halherta/16ChannelServoControllerDaughterboardDesign/README.md

# 16ChannelServoControllerDaughterboardDesign
16 Channel Servo (&amp; PWM) Controller Daughterboard Design using a PCA9685. Part of the IOT innovation station project
