halherta/16ChannelServoControllerDaughterboardDesign/16ChannelServoControllerDaughterboardDesign.kicad_pcb

## KiCad design 16ChannelServoControllerDaughterboardDesign.kicad_pcb (2025-09-30)

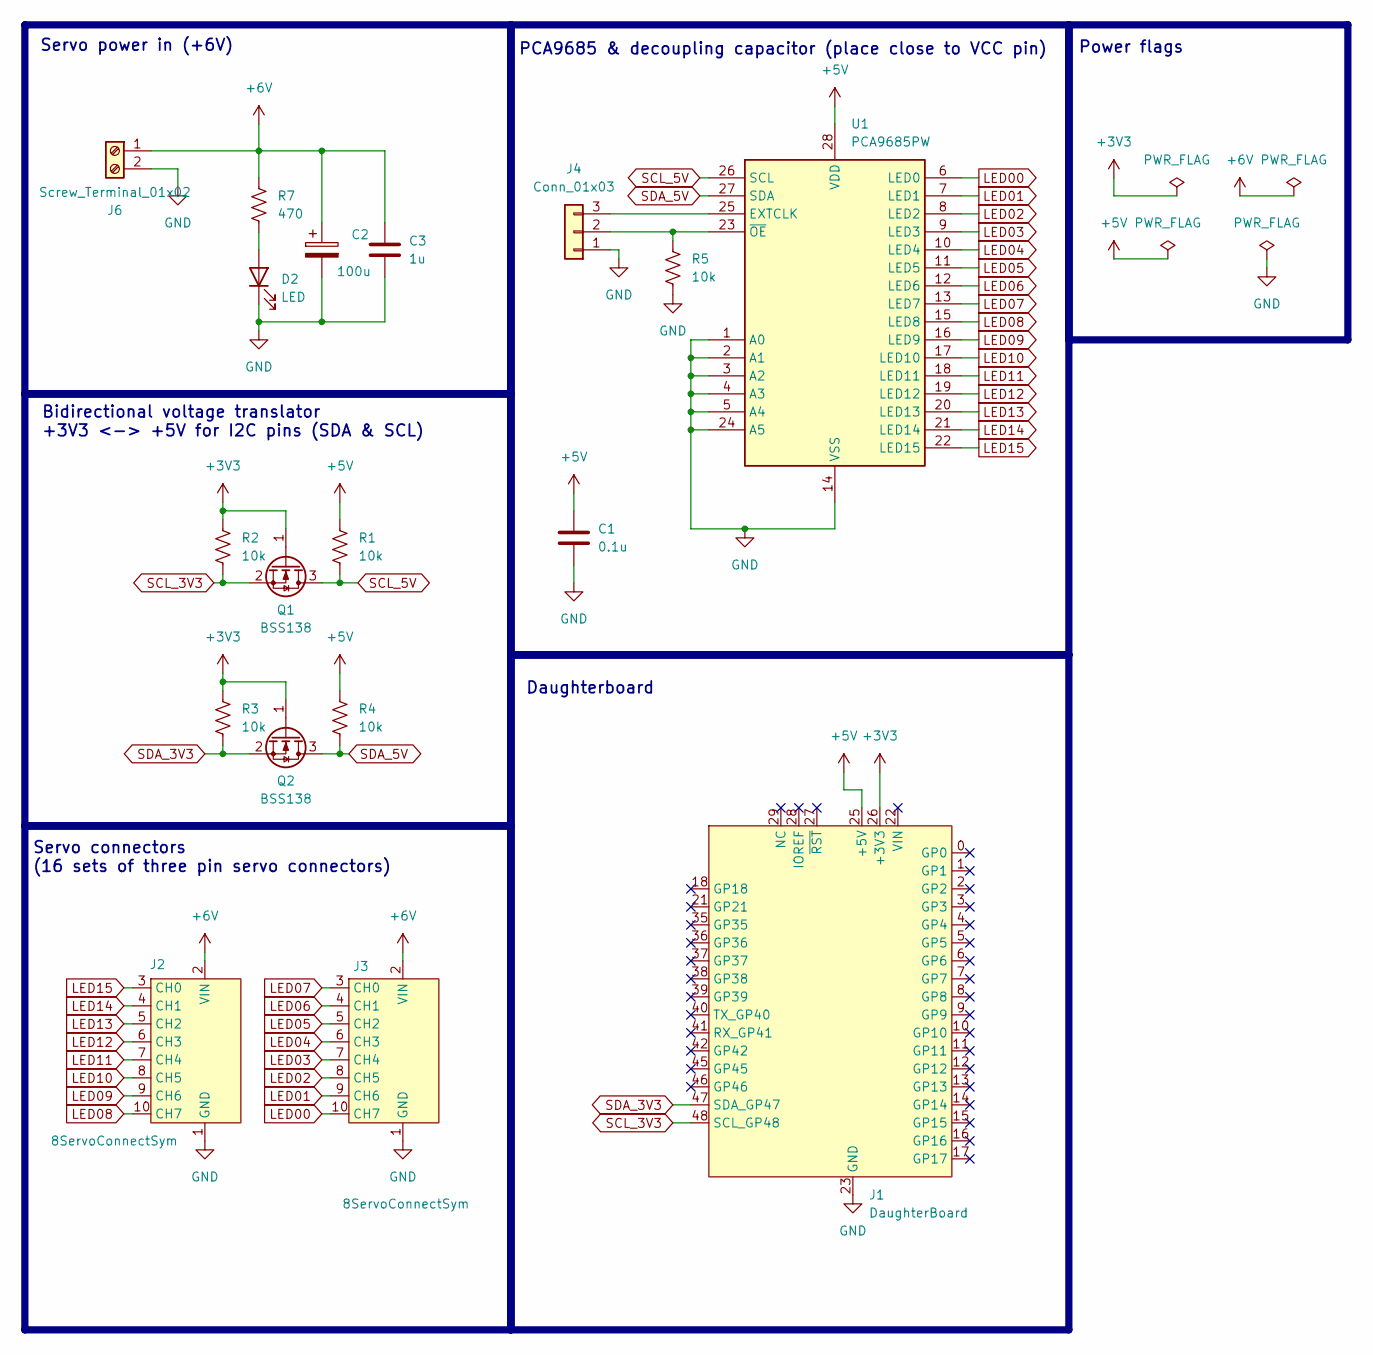
[picture p1: schematic 16ChannelServoControllerDaughterboardDesign.kicad_sch]

Parts:
C1: 0.1u; C_1206_3216Metric_Pad1.33x1.80mm_HandSolder
C2: 100u; CP_Elec_6.3x7.7
C3: 1u; C_1206_3216Metric_Pad1.33x1.80mm_HandSolder
D2: LED; LED_1206_3216Metric_Pad1.42x1.75mm_HandSolder
J1: DaughterBoard; DaughterBoardTemplate
J2, J3: 8ServoConnectSym; 8ServoConnect
J4: Conn_01x03; PinHeader_1x03_P2.54mm_Vertical
J6: Screw_Terminal_01x02; TerminalBlock_Phoenix_MKDS-1,5-2_1x02_P5.00mm_Horizontal
Q1, Q2: BSS138; SOT-23
R1, R2, R3, R4, R5: 10k; R_1206_3216Metric_Pad1.30x1.75mm_HandSolder
R7: 470; R_1206_3216Metric_Pad1.30x1.75mm_HandSolder
U1: PCA9685PW; TSSOP-28_4.4x9.7mm_P0.65mm

Connections:
+3V3: J1.26 (+3V3), J1.32 (+3V3), Q1.1 (G), Q2.1 (G), R2.1, R3.1
+5V: C1.1, J1.25 (+5V), R1.1, R4.1, U1.28 (VDD)
+6V: C2.1, C3.1, J2.2 (VIN), J3.2 (VIN), J6.1, R7.1
GND: C1.2, C2.2, C3.2, D2.1 (K), J1.23 (GND), J1.24 (GND), J1.30 (GND), J2.1 (GND), J3.1 (GND), J4.1, J6.2, R5.2, U1.1 (A0), U1.2 (A1), U1.3 (A2), U1.4 (A3), U1.5 (A4), U1.14 (VSS), U1.24 (A5)
LED00: J3.10 (CH7), U1.6 (LED0)
LED01: J3.9 (CH6), U1.7 (LED1)
LED02: J3.8 (CH5), U1.8 (LED2)
LED03: J3.7 (CH4), U1.9 (LED3)
LED04: J3.6 (CH3), U1.10 (LED4)
LED05: J3.5 (CH2), U1.11 (LED5)
LED06: J3.4 (CH1), U1.12 (LED6)
LED07: J3.3 (CH0), U1.13 (LED7)
LED08: J2.10 (CH7), U1.15 (LED8)
LED09: J2.9 (CH6), U1.16 (LED9)
LED10: J2.8 (CH5), U1.17 (LED10)
LED11: J2.7 (CH4), U1.18 (LED11)
LED12: J2.6 (CH3), U1.19 (LED12)
LED13: J2.5 (CH2), U1.20 (LED13)
LED14: J2.4 (CH1), U1.21 (LED14)
LED15: J2.3 (CH0), U1.22 (LED15)
unnamed: D2.2 (A), R7.2
unnamed: J4.2, R5.1, U1.23 (~OE)
unnamed: J4.3, U1.25 (EXTCLK)
SCL_3V3: J1.48 (SCL_GP48), Q1.2 (S), R2.2
SCL_5V: Q1.3 (D), R1.2, U1.26 (SCL)
SDA_3V3: J1.47 (SDA_GP47), Q2.2 (S), R3.2
SDA_5V: Q2.3 (D), R4.2, U1.27 (SDA)

Notes on the sheet:
Bidirectional voltage translator +3V3 <-> +5V for I2C pins (SDA & SCL)
Servo connectors (16 sets of three pin servo connectors)
Daughterboard
Power flags
Servo power in (+6V)
PCA9685 & decoupling capacitor (place close to VCC pin)

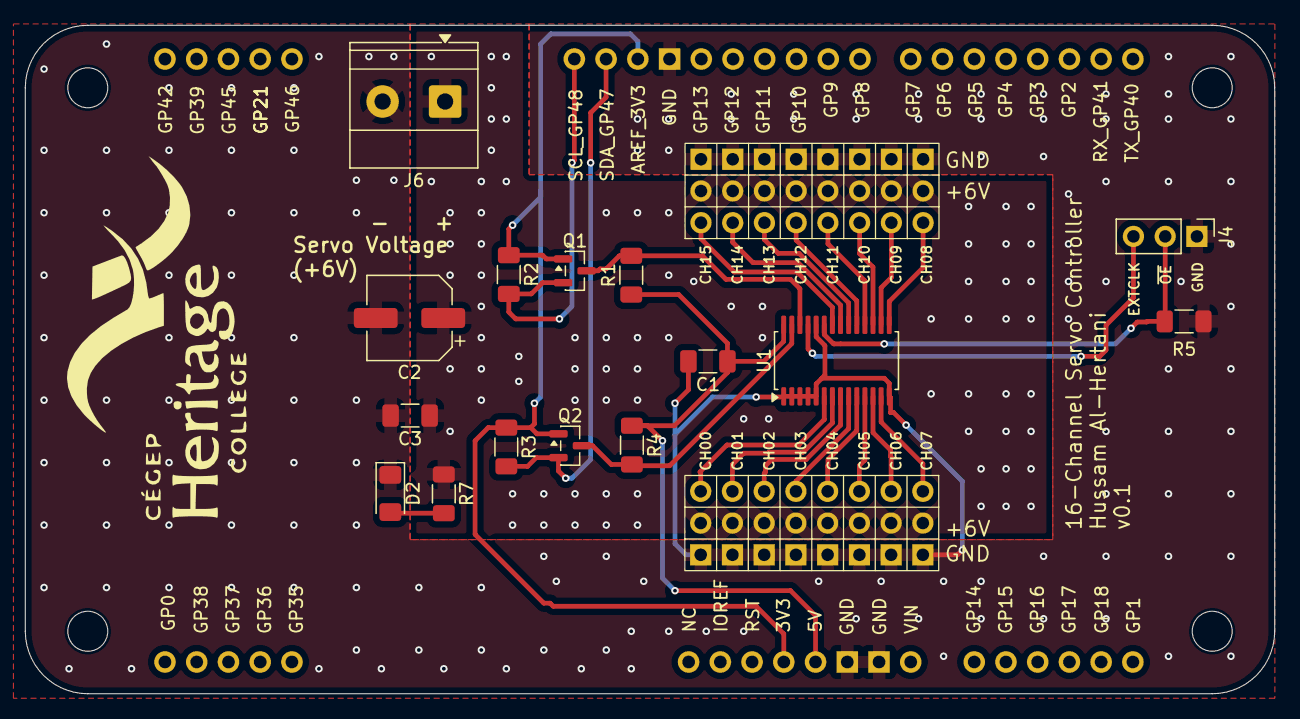
[picture p2: board 16ChannelServoControllerDaughterboardDesign.kicad_pcb from above]

Board: 2 copper layers, 100.0 x 53.5 mm, 18 parts (0 on the bottom side), 27 nets.
